rezgh92/CoolitBeat/design/DDD-innovation.md

# DDD-innovation: innovation register, PRISM-15 Rev A

> Lane `innovation`, 2026-10-16. Parent: `docs/cooling/03-architecture.md` (0.1-0.2, 2.1-2.3, 3.1-3.5, 4.1-4.3, 5.1-5.3, 7.2, 9). Inputs: every DDD lane (`DDD-core`, `DDD-grate`, `DDD-plenum`, `DDD-mech`, `DDD-mfg`, `DDD-perf`) and the verification reports under `appendix/verify/`. This is an engineering register for the design report: every benefit is a modelled P50 number (±25 % until E1-E4) with the script it comes from; every novelty statement carries the FTO caveat below. `params-innovation.json` is a stub index of the features.

**FTO caveat (applies to every row).** `appendix/verify/verify-ip.md` is engineering-level patent reading from snippets (about 40 searches, no full claim set read, WebFetch blocked). It is not legal advice. Its findings that bind this register: (a) the kerf is a *weak* design-around of the CoolIT Split-Flow 2008 family ('330/'284/'906/'513, live to about Aug-Sep 2028, '330 PTA bound about Jun 2031); about 49 % of a segment's inflow still enters through fin tips under the 1.2 mm window (`ip_entry_split.py`), and the kerf is worth 2.6 % of the cell dT, so the DOE reading stays open; (b) Microfabrica US 12,255,123 ("hybrid microjet and microchannel array") is medium-high risk unless the jets land on the lip and not on the fins, which Rev A does; (c) Intel 12,133,357 / 11,804,418 and Toyota 11,428,478 are live, close and uncharted; (d) TW I606224 is live to about 2032 for Taiwan manufacture; (e) of the five draft filings only #1 (narrow combination with numeric limits) and #5 (defensive publication of the TTV method) are worth filing; #2 and #4 are anticipated or obvious; #3 is a trade secret. No US offers, sales or evaluation units before the outside-counsel opinion (US$150-250k, weeks 2-8); US launch planned on or after 10 Sep 2028. "Novelty confidence" below is therefore the engineering team's estimate of what survives a search, not an opinion on infringement. Filings and marketing avoid "split", "between the ends" and "halves the path".

Confidence scale: **high** = no close structural match found and the combination carries numeric limits; **medium** = elements known, combination or limits possibly new; **low** = known practice, publish defensively; **none** = standard practice, listed in section 3.

## 1. Innovation register

Column key: problem it solves | mechanism | quantified benefit (script / report) | closest prior art and the difference | novelty confidence (with the FTO caveat above) | test that proves it.

### 1.1 Short, flux-graded flow length (L 7.7 mm on the TTV; 5-12 mm by zone flux)

| Field | Content |
|---|---|
| Problem | A 54 mm split-flow path carries the caloric rise and the fin-top short-circuit along the fins: CoolIT's measured 34.4 / 44.2 K at 15 kW includes a reconstructed base term of 6.6 K and a maximum-minus-average of 9.8 K. Long paths also force coarse gaps for pressure drop |
| Mechanism | 15 lines at 7.7143 mm pitch (7 inlet, 8 outlet, edge outlets with half windows) give 5,040 parallel 7.4 mm fin segments at 0.20 m/s, Re 44. Fin dP is 1.07 kPa, so the gap (0.15 mm) is set by fouling and h_eff (117 kW/m2K), not by dP. Flow length is graded by zone flux: ≥ 250 W/cm2 5-6 mm, 100-250 W/cm2 6-8 mm, 50-100 W/cm2 8-12 mm, < 50 W/cm2 12 mm (architecture 3.3, corrected: L 4 mm is never best; the ripple crest is flat within 0.35 K over L 5-8 mm) |
| Quantified benefit | Benchmark 31.1 / 38.8 K paste, 29.2 / 34.9 K PCM at base 0.85 (`perf_datasheet.out` §1; architecture 31.0 / 38.7 and 29.0 / 34.8 at 0.80, `final_thermal.out` §1). Term budget vs the CoolIT calibration: convection 10.9 vs 12.6 K, base 2.6 vs 6.6 K, 2-D penalty +0.9 vs +1.4 K (end-face exit, `vp_run2.py`); maximum-minus-average 7.8 vs 9.8 K. Capacity at Tcase ≤ 85 C: 15.7 / 18.4 kW vs ~12.9 / 14.8 kW (+22-24 %). Low-flow concession: the average is lost by 17 % at 0.25 LPM/kW (isothermal-cell caloric penalty, `perf_datasheet.out` §4) |
| Closest prior art | Harpole and Eninger (SEMI-THERM 1991, NPL) and Ciaccio US 5,088,005 (fee-expired): the manifold-microchannel concept itself. Cooligy US 7,104,312 (expired, zoned flow lengths), Toyota US 11,149,937 (graded MMC, fee-expired), HUST 12,178,022 (zigzag diverter, power module). Purdue HMMC (Garimella/Weibel) and IBM Zurich (Brunschwiler) hierarchical manifolds at 0.5-2 mm pitch, mostly two-phase or embedded. **Difference:** a 7.7 mm pitch chosen as the 2-D optimum for a *skived* 0.15/0.15 x 2.0 field on a conventional vacuum-brazed stack, with the pitch rule published as a flux table rather than a micro-fabricated array. CoolIT Split-Flow is the same idea at one slot per plate |
| Novelty confidence | **Low** as a concept (the architecture calls it a "proven subset"). The flux-graded rule is anticipated or obvious and a selection rule risks 35 USC 101 (verify-ip filing #2): publish defensively. The pitch is inside the Split-Flow DOE argument until Sep 2028 (caveat (a)) |
| Proving test | E3 OCP thermal at 6 flows on TTV-A and TTV-100, 5 plates x 3 mounts, PCM and paste, post-test BLT (architecture 1.3); the maximum must be lower than 44.2 K at every flow and the average lower from 0.75 LPM/kW up. E2 single-cell CFD confirms the 2-D model within ±25 % |

### 1.2 Kerfed skived fins with full-height entry

| Field | Content |
|---|---|
| Problem | Fluid entering a fin field from above through a window runs along the fin tips (Hele-Shaw short-circuit) and leaves the fin roots, where the heat is, under-fed; the fins are unmixed across their height at Re 35-200 |
| Mechanism | 13 interior kerfs 0.30 +0.05/-0 wide, sawn 1.925 ± 0.025 deep from the planed tip plane so the floor sits 0.05-0.10 above the fin root (never into the base; hinge ≥ 0.80), full depth over \|y\| ≤ 48.1 with an arc ramp to zero at 54.0 so the saw never touches the rim; 2 edge channels 0.35 wide (DDD-core 5). Kerf permeability w²/12 is ~8x the fin-gap value, so the kerf acts as a distribution duct feeding the segment end face over the full 2.0 mm height; kerf top ≤ 1.3 m/s, fin-gap 0.198 m/s. 15 micro-grain carbide slitting saws Ø20 x 0.28 on one arbor, wax-potted fins, tooth force 1.3-2.1 N vs 1.4-5 N fin lateral capacity, 10,080 cut sites deburred to ≤ 15 µm |
| Quantified benefit | Kerf worth 0.4 K on Rev A and 0.66 K on the draft core (architecture 3.2; `vp_cell.py` / `vp_run1.py` confirm 0.66 K at L 6: no-kerf 23.54 K); +0.30 K if the inlet kerf fills by impaction, +0.66 K if both fill (`verify-physics.md` §2c); kerf permeability ratio 4-16 moves the result ±0.25 K. Arc ramp costs +0.014 K average (`core_geom.out` §3). Cost US$2.8 at 100k (`mfg_cost.out` §3); dropping the kerfs saves US$3.4 and costs +0.4-0.7 K (`verify-close-the-losses.md`) |
| Closest prior art | Cross-cut skived fins (established practice, verify-ip #1 row); Toyota US 11,428,478 (gridded fins in an MMC sink, live to ~2040); Intel 11,804,418; Cooligy US 6,986,382 interdigitated fingers; LLNL Bonde US 5,099,311 and Walpole US 5,099,910 (expired). **Difference:** the kerf is a sub-0.3 mm saw cut that stops 0.05-0.10 above the base in a tied field, sized so its top-entry velocity stays ≤ 1.3 m/s and its area (1.33x the orifice area) does not meter; the slit is a *distribution duct*, not the fin entry. CoolIT '330 claims an inlet opening "between the ends" of a continuous channel; verify-ip finds the kerf does not end the flow path |
| Novelty confidence | **Low-medium.** Novel only as the narrow combination of filing #1 (kerf/window ratio, floor stub, orifice-to-braze clearance ≥ 0.35 mm, meter/header head ratio ≥ 6); detectable by teardown, easy to design around. The admissions risk is real: never describe the kerf as part of the inlet opening. The stronger structural fix (window narrowed to the kerf, -0.11 K, `cell2d.py`) is carried as the pre-freeze option; the no-kerf R1 fallback is non-US only (caveat (a)) |
| Proving test | E1 skive and gang-saw trial: pitch and thickness Cpk ≥ 1.33, burr ≤ 15 µm by profilometer on 3 kerfs x 5 fins per lot, root metallography, ISO 16232 flush with no particle > 50 µm. E2 single-cell CFD + water-table PIV: kerf share of segment inflow, fin-top velocity ≤ 0.5 m/s at 18 LPM. Fin-field dP taps on the first five plates: 1.07 ± 0.2 kPa viscous term (> 1.3 = filler in kerfs or windows) |

### 1.3 Off-braze-plane graded orifice meter in the grate web, jets landing on the grate lip

| Field | Content |
|---|---|
| Problem | (i) A centre-fed plenum has a momentum-driven pressure profile along y, so an ungraded meter mis-feeds the line ends by ~12 %; (ii) orifices at a braze plane draw filler and lose area; (iii) jets aimed at the fins break the 0.5 m/s fin-entry cap, erode the pressure boundary and read on the Microfabrica "microjet onto the heat-exchange region" claim |
| Mechanism | Two OFE laminations brazed in the one cycle: land plate GRT-L 1.30 (windows 1.2 x 108, recess pockets 2.70 wide x 0.80 deep from the top face, capillary-break grooves 0.15 x 0.08) and meter web GRT-W 0.40 at z 4.10-4.50 with 378 inlet orifices 0.50 x 0.99-1.12 (r 0.10) in 5 size steps spanning 1.134x in area, centred at x_line ± 1.00, alternating sides so each 0.75 lip receives 27 jets per line. Stand-off H 0.80 = 1.6 orifice widths (inside the potential core), jet footprint 0.670-1.330 on the 0.60-1.35 lip, inner margin 0.070 nominal / 0.023 RSS. Orifices ≥ 0.40 from the nearest filler (rule ≥ 0.35); the 0.3 mm mask is a starve zone and the grooves stop the capillary front. Because the plenum profile and the orifice loss both scale with u², one artwork balances every flow |
| Quantified benefit | Per-orifice max/min ±2.2 % at 9, 18, 27 and 36 LPM vs 1.118-1.122 ungraded (`grate_artwork.out`; target ±3 %); robust to Cd 0.65-0.80 (1.044-1.055), a ±2 mm window move and a two-arch feed (1.058). Meter 2.31 kPa at 1.54 m/s mean, 1.64 m/s max orifice, 2.0 m/s cap reached at 23.4 LPM (`grate_cell.out`, `perf_datasheet.out` §8). Fin-top estimate 0.40 m/s at 18 LPM vs the 0.5 cap (DDD-grate 5). Thermal cost of landing on the lip instead of the kerf floor ≈ 0 K (floor h 6 vs 12 kW/m2K changes nothing in `cell2d.py`). Enabled the 5.0 mm plenum: height 26.4 → 20.8 mm (`ctl/plenum_height.py`, `plenum_graded.py`). Per-SKU change is the web only, ~US$2-4 laser-pierced |
| Closest prior art | Cooligy US 6,986,382 / 7,156,159 (interdigitated manifold over microchannels, expired); Mikros normal-flow (NCP) laminated plates where jets through thin sheets strike the heated base; JetCool / MIT US 11,018,077 and 11,594,470 (microjets onto the package with local returns); Microfabrica US 12,255,123 (hybrid microjet + microchannel, to ~2042, parent 9,953,899 to ~2036); IBM Zurich hierarchical manifold with direct jet impingement; orifice-compensated headers in plate HX practice. **Difference:** the jets never touch the heat-exchange surface: they stagnate on a dedicated lip of the grate 1.3 mm above the fin tips and the fluid then descends a 1.2 mm window at ≤ 0.4 m/s; the meter sits 0.35-0.40 mm clear of any braze plane; the grading is a 5-step quantised area ladder solved on a 432-cell 1-D manifold model and re-issued per package |
| Novelty confidence | **Medium**, the strongest element of filing #1 (stepped recess + lip landing + clearance limits). Microfabrica risk moves from medium-high to medium-low only because of the lip landing; the 0.4 mm-offset fallback that put jets on fin tips is deleted (caveat (b)). Mikros/Jabil and IBM Zurich families not yet charted |
| Proving test | E2 single-cell CFD + water-table PIV: footprint wholly on the lip, fin-top ≤ 0.5 m/s, fixes H 0.70-0.90 and lip 0.70-0.80 (O1). Coupon Cd(Re) in both directions, Re 300-1700, 5 sizes; if Cd ≠ 0.72 every area scales by 0.72/Cd. 100 % backlit vision of orifice area before and after braze (±1 %); E1 sections show no filler within 0.15 of a window edge. Three-flow dP at Cpk ≥ 1.33 screens a mis-sized artwork (±2 % area = ±1.2 % plate dP). E4 lip erosion at 1x/1.5x/2x for 1,000 h |

### 1.4 Tied sandwich with a 0.85 mm pressure-neutral base

| Field | Content |
|---|---|
| Problem | In a conventional plate the base is a pressure vessel wall: at MAWP 1.03 MPa the 117 cm2 field carries 12 kN, so the base is 2-3 mm thick (CoolIT reconstruction base term 6.6 K) and bows under pressure and clamp, which opens PCM and LM bond lines |
| Mechanism | Fin tips (planed coplanar with the rim top within 0.02) are brazed to the grate lands with 12-15 µm BAg-8 preform ladders; the grate carries the plenum legs, the separator and the cap feet, so the pressure load on the base is self-equilibrated by 360 fins x 14 segments of ties and never enters the clamp budget (DDD-mech 5). The base can then be fly-cut after braze to 0.85 (+0.05/-0.05; 0.80-0.90 accepted; 1.0 fallback) at ≤ 20 µm flatness, Ra ≤ 0.8. The governing defect is one unbonded land strip spanning kerf to kerf; the 0.85 base is gated on E1 showing per-strip detection by the confocal proof scan (bulge ~1.8 µm at 1.55 MPa) |
| Quantified benefit | Base term 2.79 K at 0.85 vs 6.6 K in the CoolIT calibration budget and 3.29 K at the 1.0 fallback (+0.55 K average, +0.36 K max; `perf_datasheet.out` §1). Tie stress 8.9-11.6 MPa mean, 22-28 MPa local vs 40 MPa allowable at 3.1 MPa design burst; plenum wall 29.8, separator 22.8 MPa (`ctl/pkgA_dp_stress.out`, DDD-grate 8). Clamp bow 22.6 µm concave at 2 kN TTV vs thermal +18.7 µm convex at 15 kW → net -4.0 µm (`mech_calc.out` §7). Fly-cut on the tied field: foundation modulus ~29 kN/mm3, 0.3 µm under 50 N thrust, no chatter (verify-mfg #13). Unverified upside: a flat tied face reduces the mean paste BLT, -0.2 to -0.5 K per µm (`verify-close-the-losses.md` 2.5) |
| Closest prior art | Brazed plate-fin heat exchangers (fins bonded to both parting sheets, standard since the 1940s); vacuum-brazed cold plates with a lid brazed onto skived or folded fin tips (common); CoolIT compliant-member and IBM TCM clamping for flatness. **Difference:** the tie is used deliberately to take the pressure boundary out of the heat path (base thinner than any fin-root hinge rule would allow for a vessel wall) and is controlled per land strip, with the defect case (one strip, collapse 1.8-2.6 MPa, leak-tight at MAWP) analysed and screened |
| Novelty confidence | **Low** for the tie itself; **medium** for the thin-base rating logic and the per-strip screen, which is a trade secret (filing #3: unenforceable offshore and patenting would disclose it). Both are at parity with the proven-subset positioning |
| Proving test | E1 tie-braze matrix: every land strip ≥ 70 % bonded over any 10 mm (CT), unbonded-strip bulge detected at base 0.85 by confocal at 1.55 MPa, burst ≥ 4.5 MPa, no plastic set after lot over-proof 2.5-3.1 MPa, flatness ≤ 20 µm after fly-cut. E3 heated pressurised flatness scan (O-M2) separates the 22.6 and 18.7 µm terms |

### 1.5 Folded single-sheet plenum and drawn skirted cap: one external perimeter seam

| Field | Content |
|---|---|
| Problem | The draft's six stamped laminations had six external perimeter seams (incumbent: one) and were unbuildable as drawn (web/t too small; verify-mfg #5); each external seam is a leak path and a yield loss |
| Mechanism | PLN-C: one 0.80 OFE strip pierced flat (14 windows 5 x 10 at y -21/-7, 8 outlet slots, 14 bleed holes Ø0.60-1.10, 32 end tabs) then folded on a sequential corrugating machine into 16 walls / 15 channels 6.914 x 5.00 at 7.7143 pitch, closed by two comb end frames; the grate web is the floor of every inlet channel. CAP: 1.00 OFE drawn in 3 stations (skirt box, arches 12 x 8 + cross domes, Ø26 port pockets), skirt down to the core land at z 1.50 over the 121.4 rim lap; 20 mm bosses brazed in the pockets with BAg-8 rings. Every plenum, separator and grate joint lies inside the skirt, so a missed joint bypasses (25 µm gap: 0.009 LPM, invisible and harmless) and cannot leak |
| Quantified benefit | External seams 6 → 1 lap + 2 bosses (+2 tap stubs on -T SKUs) (architecture 5.1; `bom.csv`). Plenum US$4.4 and 0.165 kg vs the draft's US$7.5 / 0.19 kg; cap US$6.3 incl. bosses (`mfg_cost.out` §3; architecture 5.4 header/cap 14.5 → 5.3). Plenum wall 29.8 MPa, arch hoop 18.6, pocket 24.8 MPa at 3.1 MPa vs 40 allowable. Height 20.8 mm at the bar vs 26.4 draft and 22-28 estimated for the incumbent. Fixture pressure on the folded stack ≤ 0.10 MPa (0.08 design, TZM leaf springs, `mfg_cost.out` §1). Leak target ≤ 50 ppm leakers at shipment, ~1 FIT |
| Closest prior art | Folded heat-exchanger fins and transformer corrugations (US 5,694,803, US 6,195,874); deep-drawn cups and cold-plate covers (standard); CoolIT Split-Flow housings. **Difference:** the corrugation *is* the plenum (channel floor = the metering web), the comb frames make it self-fixturing, and the drawn skirt makes every inner edge internal in a single braze |
| Novelty confidence | **Low** (assembly method; publish defensively with the OCP disclosure). No IP exposure found |
| Proving test | E1 3-channel fold coupons (bend radius, K 0.31-0.39, springback), then Build A (wire-EDM fallback); He leak ≤ 1e-6 mbar·L/s dry, 100 % proof 1.55 MPa, lot burst ≥ 4.5 MPa after thermal cycling; IR flow screen for bypass (blocked line resolution 5-10 mm) |

### 1.6 Doubled outlet header + 0.5 kPa outlet orifice row for segment balance

| Field | Content |
|---|---|
| Problem | The meter fixes each line's flow but not the left/right split of a kerf's flow into its two neighbouring segments; only the 1.07 kPa viscous fin resistance opposes outlet-side pressure differences, so segment max/min reached 1.23-1.43 in the draft (1.41-1.71 at 36 LPM) |
| Mechanism | Four outlet arches (322 mm2 per half, 0.47 m/s) against two inlet arches (161 mm2), so the outlet header runs at half the inlet velocity head; plus a row of 54 (edge 27) Ø1.00 holes in the outlet window web adding 0.50 kPa at each line's nominal flow, lumped per line (`grate_outlet_row.py`) |
| Quantified benefit | Segment max/min at 18 LPM: 1.287 with a single outlet header → 1.092 with both fixes (1.100 header doubled, no row); at 36 LPM 1.546 → 1.148 (`grate_outlet_row.out`). Weakest segment +0.41 K core at 18 LPM against the 1.5 K flow hot-spot allowance (margin 1.09 K, `perf_datasheet.out` §2). Cost 0.50 kPa and no height; outlet header 1.55x margin against the 0.9 m/s CDA band for > 60 C return |
| Closest prior art | Outlet-side restriction and header area ratios for branch balance are textbook manifold design (Bajura and Jones 1976; Majumdar 1980); Cooligy and CoolIT headers. **Difference:** none of substance; the specific 2:1 header ratio and 0.5 kPa row are design values |
| Novelty confidence | **None.** Listed in section 3; not claimed |
| Proving test | E2 water table: segment-level max/min by dye and IR ≤ 1.15 at 18 LPM, ≤ 1.20 at 27 LPM (combined along-plenum and segment); E3 maximum-minus-average 7.7 K paste / 5.7 K PCM predicted |

### 1.7 Fin-field dP taps as the fouling and build signature

| Field | Content |
|---|---|
| Problem | Port-to-port dP is 81 % inertial (meter, ports, headers): a 10 µm deposit on each fin wall raises fin dP 54 % but plate dP only 6-8 %, so no port measurement can see fouling or a bad tie braze (`verify-hydraulics.md` §4) |
| Mechanism | Two Ø1.00 gun-drilled or EDM taps along y at z 1.40 from -y bosses at x 0.000 (inlet line k = 7) and x +15.429 (outlet line k = 9), 15.35 long, with Ø1.65 x 4.0 counterbores for Cu 1.6 x 0.3 stubs brazed in the same cycle (DDD-core 3.10; -T SKUs). They read the fin-field pressure difference (inlet kerf to outlet kerf): the 1.07 kPa viscous term, linear in flow and viscosity |
| Quantified benefit | Fouling sensitivity x7-9 over port taps; thresholds +10 % warning (≈ 2 µm per wall), +25 % service (≈ 5 µm) (architecture 7.2). Production use: > 1.3 kPa = filler in kerfs or windows, < 0.9 kPa = missed tip joints (bypass) (`perf_datasheet.md` §9 item 4). Converts the unmeasurable 10-year life into a dose qualification: 100x particle dose for 1,000 h (~11 years) with ≤ 10 % fin-field dP drift and ≤ 1 K (E4). Cost in the TAP/GUARD line US$8.3 total |
| Closest prior art | Heat-exchanger fouling monitoring by dP (universal); filter dP alarms; CoolIT US 9,052,252 (in-plate leak sensing); NVIDIA "intelligent plate" filings (uncharted). **Difference:** the taps straddle only the viscous element inside a manifold plate, which is possible because the inlet and outlet plenums are physically separate layers above the field; sensor records published as PLDM/Redfish, plate stays passive |
| Novelty confidence | **Low-medium.** Possibly new as a cold-plate feature; of little value as a patent (infringed by the operator, detectable only in a fleet). Publish with the OCP method; chart CoolIT '252 and the NVIDIA filings before any tray-module design |
| Proving test | First five plates: fin-field dP at 6 flows against the 1.07 kPa model; E4 dose test with the taps as the primary metric; correlation of tap reading with CT-confirmed tie defects on E1 coupons |

### 1.8 Per-package artwork zoning

| Field | Content |
|---|---|
| Problem | Lidded packages (4 dies at 350 W/cm2 + 16 HBM at 40 W/cm2 on 110 x 120 mm) need 85-90 % of the flow under the die block and 0.3-0.5x average per area under HBM; a new zoning in a machined or die-stamped manifold costs a US$0.4-1.0 M die set and months |
| Mechanism | Only GRT-W (0.40 strip, laser-pierced, 100 % backlit vision) changes per package; land plate, plenum fold and cap are per pitch family. Zoning by heat: die zones at line pitch 5.5 (L 5.5), HBM and margin at 11; every zone fed in parallel so HBM is never downstream of a die; unheated margin gets only plenum-end bleeds (Ø1.10 for 4 % of line flow; the draft's Ø0.60 gave 1.2 %). The HBM pedestal step S (0-0.40, ±0.05) is cut in the same post-braze fly-cut |
| Quantified benefit | PRISM-G example: 17 lines, 840 holes, 190.1 mm2 inlet area, die-zone orifices 2.30 kPa at 1.54 m/s, HBM 2.90 kPa (`grate_artwork.out` §PRISM-G; `artwork_prism_g_example.csv/.dxf`). Hottest die cell with LM: ~94-98 C case vs ~121 C for a split-flow reconstruction, model vs model (`prism_scorecard.out` §6); P-grade ~84-88 C. Tooling cost per zoning ~US$2-4 per plate and weeks, not a die set. Caveat found: HBM orifices reach 2.21 m/s at 150 % rated, so a product artwork uses L 8 in the HBM zone or the -HF die meter |
| Closest prior art | Cooligy US 7,104,312 (zoned manifolds, expired); Corintis topology-optimised cold plates; Toyota US 11,149,937; the project's own PSM-12 slit-pitch zoning. **Difference:** the zoning lives in a flat 0.4 mm perforated sheet solved by a 1-D manifold tool, so it is a data file, not a part |
| Novelty confidence | **Low** (anticipated / obvious; 101 risk on the rule). The zoning tool and its calibration are the moat (architecture 9: trade secret); the artwork method goes into the defensive publication (#5), after clearing NVIDIA US 12,446,195 for the TTV itself |
| Proving test | E3 on the real-package TTV-D (die + HBM heaters) with the -G artwork: die and HBM case temperatures against the zoned model; segment balance by IR at 2 kW |

### 1.9 Interface tiers set by face finish

| Field | Content |
|---|---|
| Problem | One brazed plate must serve drop-in PCM users, OEM liquid-metal co-design and bare-die chip co-design without a new core |
| Mechanism | The tier is chosen after braze, in the fly-cut and finishing cell: T1 lapped bare Cu for PCM (0.055 cm2K/W at 25 psi; 0.07 at 4-12 psi package retention); T2 3-5 µm electrolytic Ni on the face only for Ga-In LM, 20-30 µm bond line, non-fluorinated dam, no Al in the LM zone; T3 crowned stepped pedestal ±0.05 with Ni or W barrier for bare die; T3B micro-channel-lid insert on the roadmap |
| Quantified benefit | TIM term 9.0 K paste → 7.1 K PCM → 1.9 K LM: 31.1 / 38.8 → 29.2 / 34.9 → 24.1 / 28.9 K (`perf_datasheet.out` §1); capacity 15.7 → 18.4 → 25.4 kW thermal (19.5 velocity-rated); inlet allowed 46.2 → 50.1 → 52.3 C. Form rule 0-10 µm concave at 20 C (IR-M5) because corners lift 13-19 µm hot |
| Closest prior art | Ni-plated faces for liquid metal (Indium Corp. and Coollaboratory application notes), stepped pedestals for HBM (every GPU plate), lapped Cu for PCM. **Difference:** none |
| Novelty confidence | **None.** Section 3; not claimed. CoolIT compliant-member patents ('886/'733, ~2040) are low risk for the T3 spring-screw gimbal but must be charted |
| Proving test | E3 PCM and paste on TTV-A; E5 LM on the Ni-plated twin fixture (17-4PH, no Al), 1,000 h at 85 C with BLT and intermetallic sections |

### 1.10 Filtration ladder

| Field | Content |
|---|---|
| Problem | A 0.15 mm gap behind a 50 µm absolute filter has ~7 years of exclusion life (a 0.2 mm gap ~15); the drop-in plate cannot win fouling life at equal filtration and must not sieve anywhere upstream of the fins |
| Mechanism | Passage hierarchy port 20 > header 8 > plenum 5 > window 1.2 > orifice 0.5 > kerf 0.3 > gap 0.15 mm, every stage ≥ 3x the last filter's absolute rating. Ladder: supplied tray cartridge ≥ 150 cm2 pleated 33 µm absolute 316L with dP taps and dry-break valves → plate guard 50 µm absolute square-weave 316L as an inside-out radial diffuser in the inlet boss (≥ 25 cm2, 0.12 m/s face) → fins. The plate is symmetric and back-flushable at 1.2x rated through a 25 µm bag (Cd qualified in reverse) |
| Quantified benefit | Exclusion life ~12 years behind the 33 µm cartridge vs ~7 at 50 µm (relative Wyss-based model, `appendix/physics/fouling-filtration.md`); cartridge life to 50 % blockage ~160 / 16 / 1.6 days at the three assumed loop concentrations, guard alone 65 / 6 / 0.6 days (architecture 7.2). Guard dP 0.1-0.2 kPa clean (0.30 booked); diffusing the port jet also holds line max/min at 1.03 instead of 1.06 (`final_segbal.out`). R+ grade behind the cartridge: 32.2 / 40.3 K on the 100 cm2 hard mode (win P 0.69 / 0.79) |
| Closest prior art | Filtration-to-gap rules of thumb, OCP and vendor loop guidance, strainer-in-port designs. **Difference:** none beyond stating the numbers |
| Novelty confidence | **None** (filing #4 obvious; a system claim would be infringed by customers). Publish in the OCP contribution |
| Proving test | E4: ISO 12103 + CuO + EPDM dose at 100x for 1,000 h with the fin-field taps; cartridge and guard dP curves; back-flush recovery; the "10-year dose qualified" claim replaces any life claim |

## 2. Design story (one page, plain engineering)

The incumbent plate solves a 15 kW problem the way every cold plate has for twenty years: a thick copper base as the pressure vessel wall, fins on top, and a lid. Coolant comes in one end of the fin field and runs tens of millimetres along the fins. That long path does three bad things at once. The coolant warms as it goes, so the far end runs hotter; the pressure drop of a long thin channel forces the designer to coarsen the gaps, which cuts the heat-transfer coefficient; and because the fluid enters from above and the fins are unmixed across their height, a good share of it runs along the fin tips and never reaches the roots where the heat is. The base, being a vessel wall, is 2-3 mm thick and adds several kelvin of its own.

PRISM takes those four problems apart one at a time with ordinary processes. First, it cuts the path to 7.7 mm by feeding and draining the fin field from above at fifteen lines: 5,040 short segments in parallel instead of a few hundred long ones. The fin dP falls to about 1 kPa, so the gap can be the 0.15 mm that heat transfer and filtration want rather than what pressure drop allows. Second, under every feed and drain line a 0.3 mm saw kerf lets the coolant enter the segment over the full 2 mm fin height, which closes the tip short-circuit and is worth about half a kelvin. Third, the fins are brazed at their tips to a grate above them, so the fin field itself carries the pressure load as thousands of small ties. The base stops being a vessel wall and is fly-cut after braze to 0.85 mm, flat to 20 µm; it no longer bows under pressure or clamp, which is what lets PCM and liquid metal hold their datasheet resistance. Fourth, the grate is also the meter: graded orifices in a thin web above a stepped recess set each line's flow so that it is uniform along the plenum at every flow rate, because the plenum's pressure profile and the orifice loss both scale with velocity squared. The jets strike a lip of the grate, not the fins, and the fluid then descends a wide window at low speed.

Everything above the grate is sheet metal: a plenum folded from one strip, a separator, and a cap drawn with its own skirt that laps onto the base land, so the plate has one external seam plus two port bosses and every internal joint can only bypass, never leak. The whole stack is brazed in one vacuum cycle at 0.08 MPa fixture pressure. The predicted result at the published 15 kW, 18 LPM point is 31.1 / 38.8 K on paste against the measured 34.4 / 44.2 K, 29.2 / 34.9 K on a PCM pad, at 7.6 kPa plate pressure drop, 20.8 mm at the bar and 1.24-1.28 kg, for about US$165 at 100k per year. The honest concessions are that it costs about 31 % more per plate (parity per kW), has a shorter fouling exclusion life at equal filtration and therefore ships with a 33 µm tray cartridge, loses the average at very low flow, and has no field record. None of the parts is new. What is new is the way four known ideas are made to hold each other up in one brazed stack built from catalogue processes, with the numbers that make them fit.

## 3. Not novel, not claimed

| Item | Why it is standard practice |
|---|---|
| Skived OFE copper fins 0.15/0.15 x 2.0 mm | inside the published CTX-class skiving envelope (fin ≥ 0.08, centre distance ≥ 0.16 mm) |
| Manifold-microchannel topology (feed from above, short along-fin path) | Harpole/Eninger 1991, Ciaccio US 5,088,005, Cooligy, Purdue HMMC, IBM Zurich |
| Brazing fin tips to the layer above (the tie) | plate-fin HX practice; vacuum-brazed lidded cold plates |
| Outlet-side restriction and 2:1 header area for branch balance (1.6) | manifold textbooks (Bajura and Jones) |
| Orifice-compensated headers | plate HX and fuel-rail practice; the u² argument is elementary |
| Folded corrugations, comb end frames, deep-drawn caps, brazed port bosses | HX forming (US 5,694,803, US 6,195,874) and sheet-metal practice |
| Single-cycle vacuum brazing with BAg-8 preforms, Ag plating or Cu-Sn TLP | standard joining routes; C2 is a cost route, not an invention |
| Post-braze fly-cut face, lapped Cu, Ni plate for LM, HBM pedestal step (1.9) | every lidded-GPU plate and LM application note |
| 50 µm guard screen, 33 µm tray cartridge, gap ≥ 3x filter rating (1.10) | filtration rules of thumb; OCP guidance |
| dP-based fouling monitoring and filter alarms (1.7, generic part) | HX operations practice |
| Captive spring screws, load frame, backplate, shoulder-screw pass-throughs | retention hardware practice |
| Flux-graded flow-length table (1.1) and heat-based zoning (1.8) | Cooligy '312, Toyota '937, HUST '022; a selection rule |
| He leak, proof, lot burst, IR flow screen, 3-point dP at Cpk ≥ 1.33 | production test practice; the per-strip confocal method is a trade secret, not a claim |

## 4. Stretch innovations (not in Rev A)

**S1. Staggered (chevron) line pattern to halve the kerf-to-kerf ripple.** The maximum carries half the computed case ripple, 5.39 K pk-pk at base 0.85, because every fin gap sees the same inlet-outlet sequence along x and the base can only smooth it over the 3.7 mm half-pitch by lateral conduction. If adjacent lines were offset by half a segment along y (a chevron or stepped kerf and matching chevron plenum channels), the hot end of one cell would face the cold end of its neighbour 0.3 mm away across a fin, and the conduction length that smooths the ripple would fall from the 3.7 mm half-pitch to about half the stagger period. Conduction smoothing scales roughly with length squared, so a 4 mm stagger period could cut the ripple by a factor of two or more, worth about -1.3 K on the maximum and nothing on the average. Caveat: gang saws cut straight lines, so the kerfs would need wire-EDM or laser (the kerf is 2.8 US$ today, perhaps 8-15 as EDM), the plenum fold tool becomes a chevron tool, the along-plenum artwork solver becomes 2-D, and a transverse slot pattern over parallel channels reads closer to the Cooligy and Split-Flow art, so it would need its own chart.

**S2. Viscosity-driven self-balancing of hot segments.** Fin dP is viscous (∝ µ u) and the PG25 film viscosity falls about 30 % between 35 and 50 C (1.60 → 1.12 mPa·s). At fixed segment pressure, a segment under a hotter zone would therefore draw more flow in proportion to its own temperature rise, a passive negative feedback that an inertial meter deliberately suppresses (the meter was chosen so the balance is flow-independent). If a zoned SKU moved part of the 2.3 kPa inertial meter budget into a viscous element (a longer or thinner outlet path, or a laminar-flow row of 0.2 mm slots at Re < 100), a 10 K hotter segment would self-feed by 10-15 % with no moving parts. Caveat: the plenum profile sensitivity that the u² meter cancels comes back in proportion to the viscous share; the gain is confined to zones with ≥ 10 K local coolant rise; the 0.2 mm viscous element breaks the "gap ≥ 3x filter" ladder unless it sits downstream of the fins; and water loops (µ 0.55 mPa·s, weaker temperature slope) get less than half the effect. Worth a `cell2d`/`plenum_graded` study, not a build.

**S3. 0.60 mm base with 100 % per-strip tie verification by lock-in thermography.** The base term is 3.29 K per mm (2.79 K at 0.85), so a 0.60 base would save about 0.8 K on every TIM and 0.5 K on the maximum, and it is still 4x the 0.15 fin thickness for the fly-cut. The pressure-neutral tie makes it structurally possible: wall and tie stresses do not change with base thickness. What changes is the governing defect: one unbonded land strip collapses at 1.8-2.6 MPa at 0.85 and, scaling with t², at about 0.9-1.3 MPa at 0.60, which is at or below MAWP 1.03 MPa, so it stops being a rating problem and becomes a safety problem that the confocal proof scan alone (resolution 1 µm, bulge ~1.8 µm at 0.85) cannot be trusted to catch at 100 %. The enabling step is a second independent screen: lock-in or pulsed thermography on the as-brazed face before fly-cut, where an unbonded strip 7.4 x 1.8 mm shows as a phase lag of the order of the fin-tip joint's contact resistance over a 0.6-0.85 mm copper skin (thermal diffusion time L²/α ≈ 9 ms for 1 mm Cu at α 1.1e-4 m2/s, so a 5-30 Hz lock-in band). Caveat: the method is unproven on a 50 %-solid fin foundation that itself conducts heat sideways; it would need an E1 sub-study with deliberately unbonded strips, and the filing route is trade secret (filing #3 logic), so it protects only our own plates.

## 5. Files

| File | Content |
|---|---|
| `DDD-innovation.md` | this register |
| `params-innovation.json` | stub: feature ids, novelty confidence, filing or publication route, proving test, source scripts |
| Sources | `appendix/verify/verify-ip.md`, `verify-physics.md`, `verify-hydraulics.md`, `verify-manufacturing.md`, `verify-close-the-losses.md`; `appendix/verify/final/final_thermal.out`, `final_segbal.out`; `appendix/verify/ctl/plenum_graded.py`, `plenum_height.py`, `pkgA_dp_stress.out`; `appendix/verify/ip_entry_split.py`, `vp_cell.py`, `vp_run1-3.py`; `design/grate_artwork.out`, `grate_cell.out`, `grate_outlet_row.out`, `perf_datasheet.out`, `mech_calc.out`, `mfg_cost.out`, `core_geom.out`, `bom.csv` |
