rezgh92/CoolitBeat/appendix/design/proposal-jet-hybrid.md

# JetFin Hybrid (JH): a nozzle-metered slot-jet-into-micro-fin cold plate (key: jet-hybrid)

Architecture proposal, 2026-10-13. Benchmark: CoolIT 15 kW Split-Flow coldplate (June 2026): 15 kW, 18 LPM PG25, 45 C inlet, 34.4 K average / 44.2 K maximum case-to-inlet, paste TIM, pressure drop undisclosed (our reconstruction ~22-25 kPa, band 17-42 kPa). All performance numbers come from `design/jet/jet_hybrid_model.py` (full output in `design/jet/jet_hybrid_model.out`). That script imports the programme's `coldplate_model.py` unchanged for the CoolIT and HMMC reference rows and uses the same series network (isothermal-cell caloric term, TIM, base, convection, hot spot = flow term + TIM scatter) on the calibrated 117 cm2 footprint. Scoping accuracy is +/-25-30 % per term. It is not CFD.

## 1. Concept in one page

**What it is.** JH is a copper plate with a three-level manifold, diffusion-bonded in one furnace cycle. The last manifold level is a two-layer **nozzle-tie laminate** bonded directly onto the tips of a skived fin field (0.15 mm gaps, 0.10 mm fins, 2.0 mm tall, 1.0 mm base). The laminate carries 0.22 mm slot nozzles at 8 mm pitch, interleaved with 1.0 mm return slots. Each slot nozzle crosses all 432 fin gaps. In each gap it issues a planar jet at 1.55 m/s (18 LPM) that hits the base between the fins, turns, runs 3.4 mm along the channel and rises into the next return slot. The nozzle does three jobs at once:

1. **Metering.** The nozzle carries 1.76 kPa of the 1.97 kPa branch, which is 6.4x the header dynamic head. It is inertial, so flow uniformity does not depend on flow rate.
2. **Zoning.** The nozzle open-area map is the power map, set by photo-tool artwork.
3. **Heat transfer.** The plate pays the metering loss anyway. JH spends it at the fin roots, where the jet raises h, instead of in a comb that sits 8 mm upstream.

Over the dies of a real package the nozzle pitch closes to 6 mm (4 mm as a stretch option), and 91 % of the flow goes there. Over HBM and unheated margins the laminate carries open, upstream-metered slots with no jets. So the plate puts jets over the dies and metered channels over the HBM.

**The answer the lens was asked for.** Do jets beat the hierarchical manifold micro-channel (HMMC) at equal pumping power and equal fouling constraints?

- **As an area-filling core, no.** Continuity fixes the problem. At 18 LPM over 117 cm2 the volumetric flux is only 2.56 cm/s, so a fouling-tolerant 0.3-0.5 mm nozzle array reaching 1-5 m/s must be sparse (2-6 mm pitch). Martin, Womac and a laminar stagnation model then give area-averaged h of only 9-32 kW/m2K at 4-40 kPa (section 2.1). That is 4-14x below the HMMC-R's 127 kW/m2K finned h_eff at 5-6 kPa. The literature's 100-300 kW/m2K microjets use 31-150 um nozzles at 10-40x our flux density.
- **As a hybrid on the same 0.15 mm fins, marginally on a uniform 15 kW TTV.** h_eff rises from 127 to 147 kW/m2K (+15 %) at the same plate dP (5.5 vs 5.7-6.0 kPa). That is worth -1.1 K average / -1.2 K maximum, or -1.3 K at equal pumping power. This is inside the model's uncertainty band.
- **Over hot spots, yes.** At 350 W/cm2 reticle dies with heat-proportional zoning, the die-zone h_eff is 158 kW/m2K (6 mm pitch) to 172 kW/m2K (4 mm pitch), against 127-133 for the open-slot manifold. That is -3 to -7 K at the hottest die. It reaches the HMMC performance core's (HMMC-P) result without its 33 um loop filtration.
- **On coarse, fouling-proof channels, decisively.** Jets add +45 % h_eff to a 0.30 mm-gap core. That makes possible a screen-free SKU that still beats CoolIT on every thermal metric.

**Headline at 15 kW / 18 LPM / 45 C (robust core JH-R, Tier-1 PCM pad, Monte-Carlo median and P90 in brackets):**
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
