rezgh92/CoolitBeat/cad/renders/section_header.png

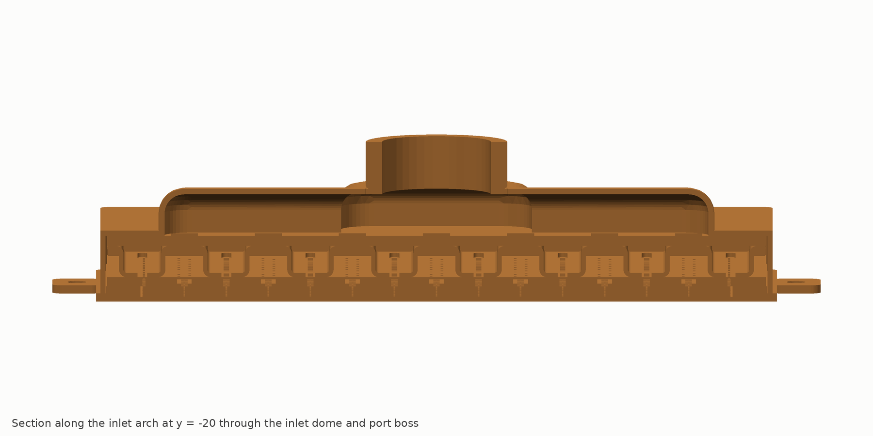
cad/renders/section_header.png
