rezgh92/CoolitBeat/cad/renders/section_inlet_closeup.png

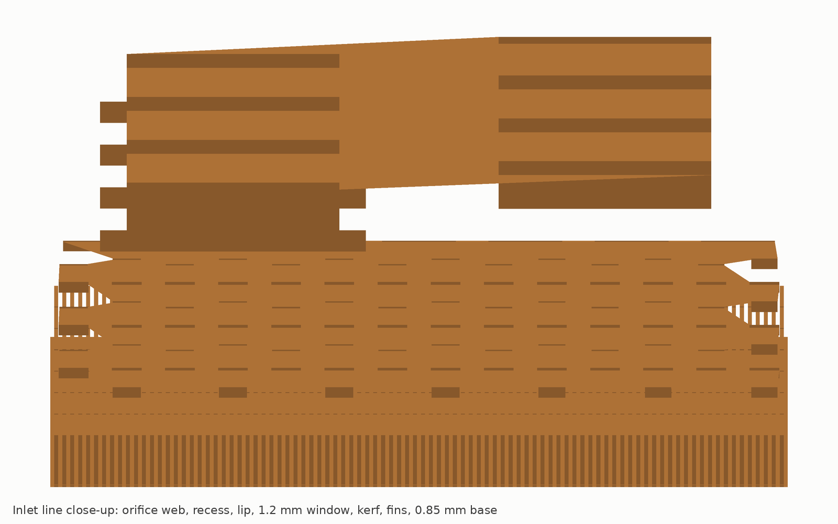
cad/renders/section_inlet_closeup.png
