rezgh92/CoolitBeat/cad/drawings/plenum_flat.dxf

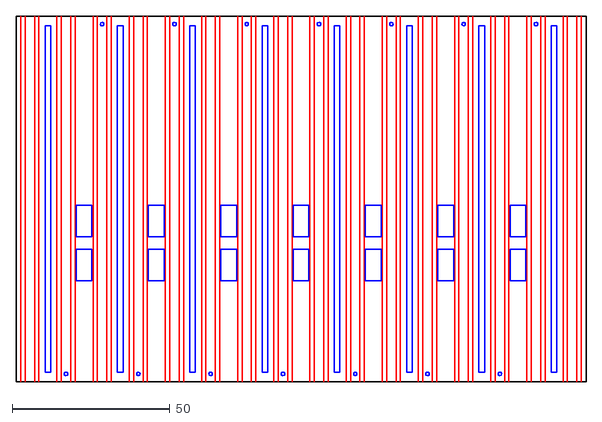
[picture p16: CAD file, 2026-10-16]
cad/drawings/plenum_flat.dxf
180.9 x 116.0
