rezgh92/CoolitBeat/cad/out/boss_out.stl

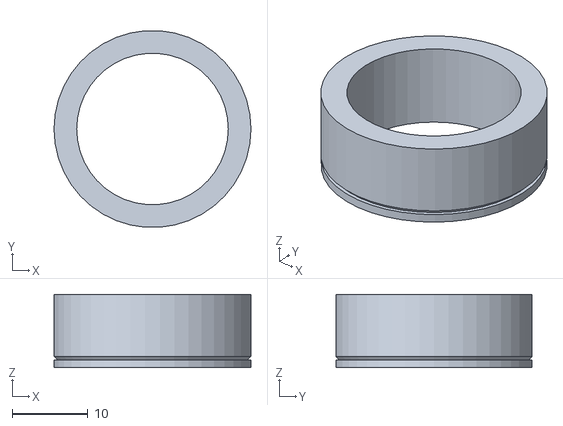
[picture p17: CAD file, 2026-10-16]
cad/out/boss_out.stl
26.0 x 25.9 x 9.70
