rezgh92/CoolitBeat/design/artwork_prism15_ttv.dxf

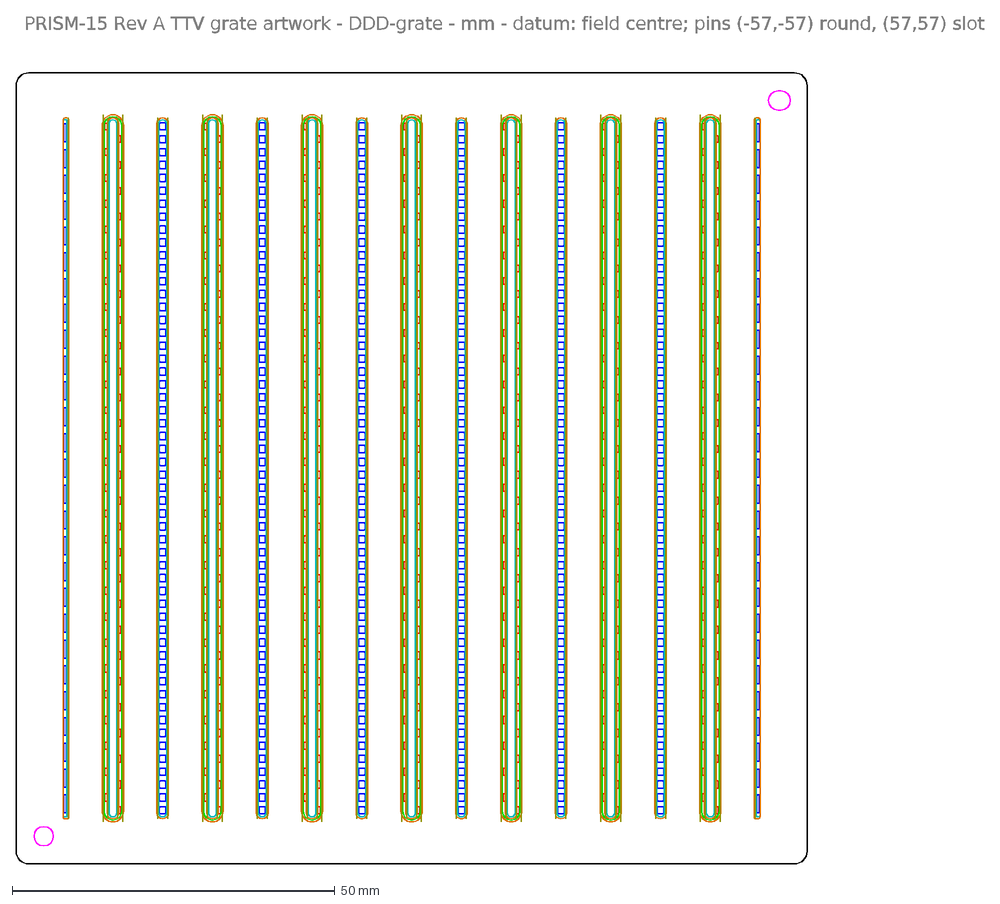
[picture p18: CAD file, 2026-10-16]
design/artwork_prism15_ttv.dxf
PRISM-15 Rev A TTV grate artwork - DDD-grate - mm - datum: field centre; pins (-57,-57) round, (57,57) slot
