rezgh92/CoolitBeat/cad/drawings/artwork_prism_g_example.dxf

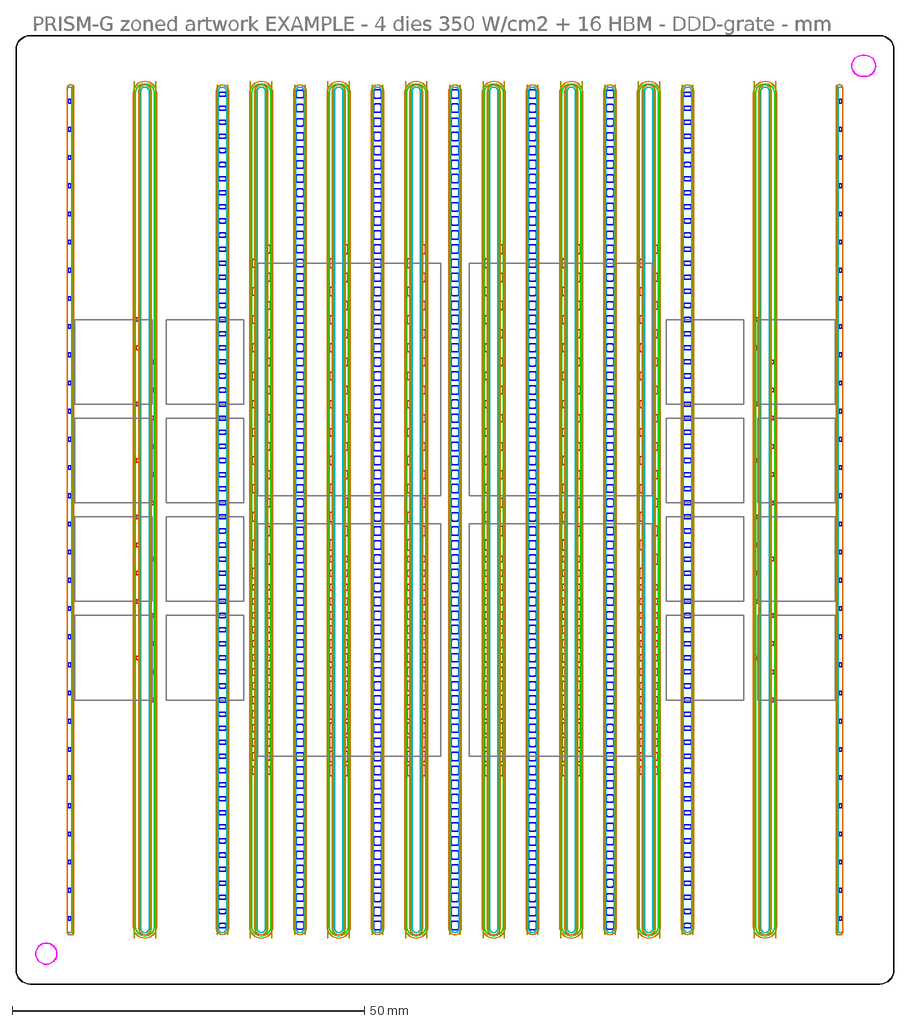
[picture p19: CAD file, 2026-10-16]
cad/drawings/artwork_prism_g_example.dxf
PRISM-G zoned artwork EXAMPLE - 4 dies 350 W/cm2 + 16 HBM - DDD-grate - mm
