rezgh92/CoolitBeat/cad/out/grate_web.stl

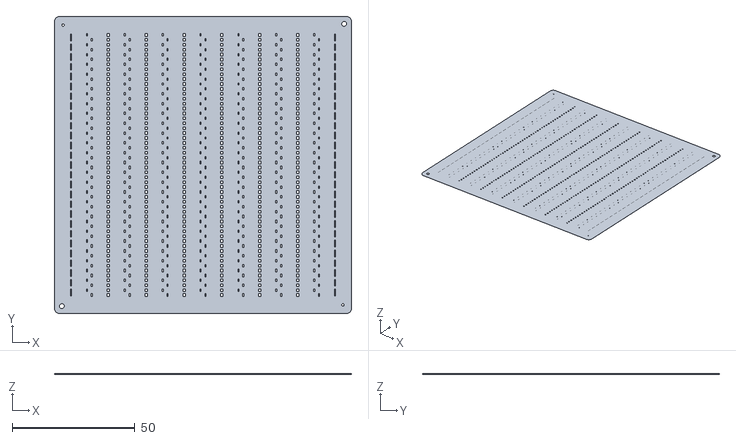
[picture p20: CAD file, 2026-10-16]
cad/out/grate_web.stl
121.0 x 121.0 x 0.4
