rezgh92/CoolitBeat/cad/out/ttv_block.stl

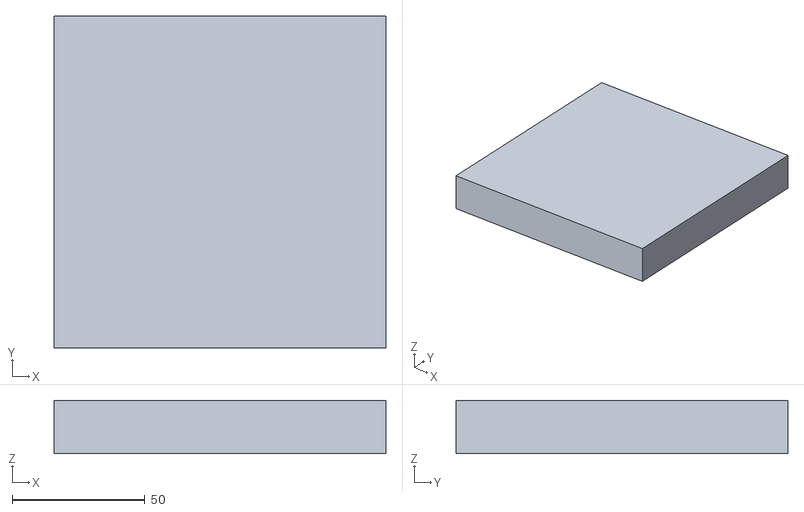
[picture p21: CAD file, 2026-10-16]
cad/out/ttv_block.stl
125.0 x 125.0 x 20.0
