rezgh92/CoolitBeat/cad/drawings/separator_windows.dxf

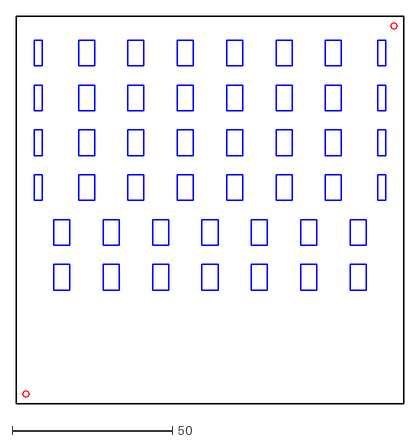
[picture p22: CAD file, 2026-10-16]
cad/drawings/separator_windows.dxf
121.0 x 121.0
