rezgh92/CoolitBeat/cad/out/plenum.stl

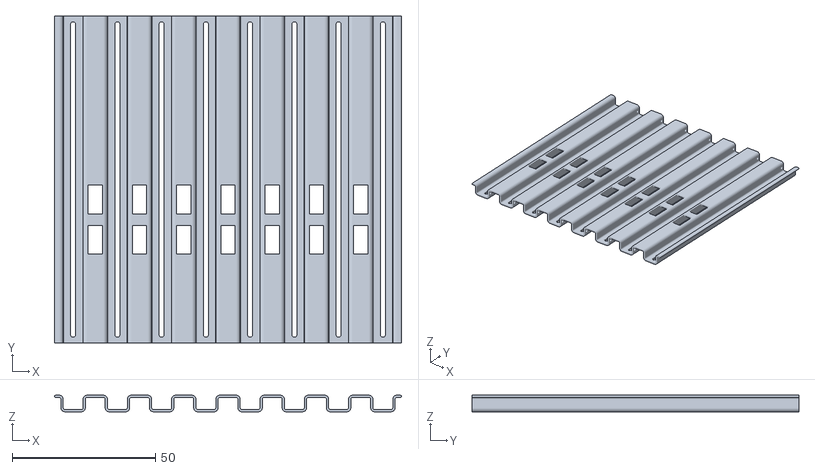
[picture p23: CAD file, 2026-10-16]
cad/out/plenum.stl
121.0 x 114.0 x 5.80
