rezgh92/CoolitBeat/cad/out/section_outlet.stl

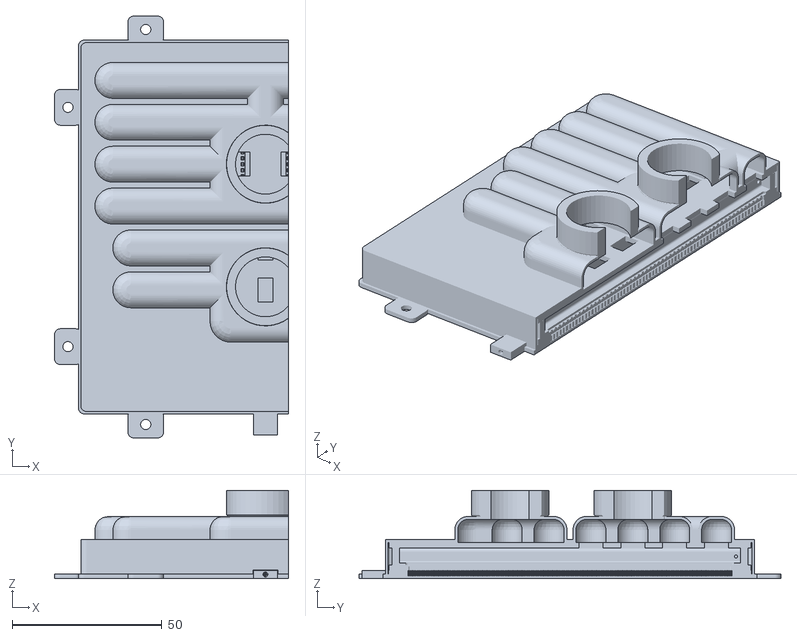
[picture p24: CAD file, 2026-10-16]
cad/out/section_outlet.stl
78.2 x 141.0 x 29.5
