rezgh92/CoolitBeat/cad/out/ttv_tiles.stl

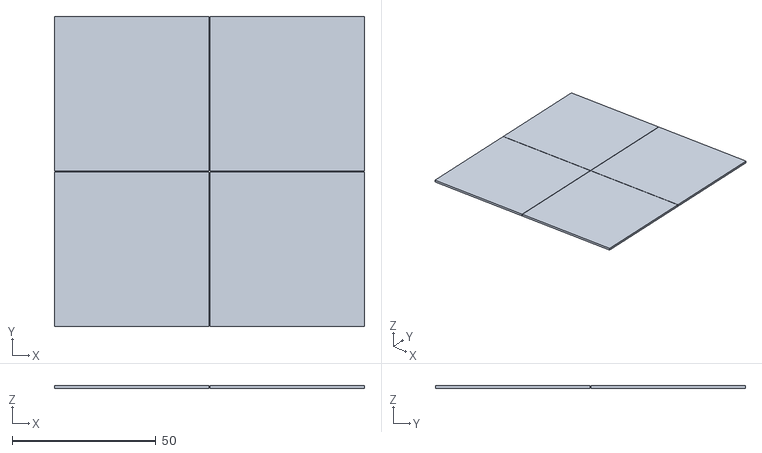
[picture p25: CAD file, 2026-10-16]
cad/out/ttv_tiles.stl
107.8 x 107.8 x 1.00
