rezgh92/CoolitBeat/cad/out/section_across.stl

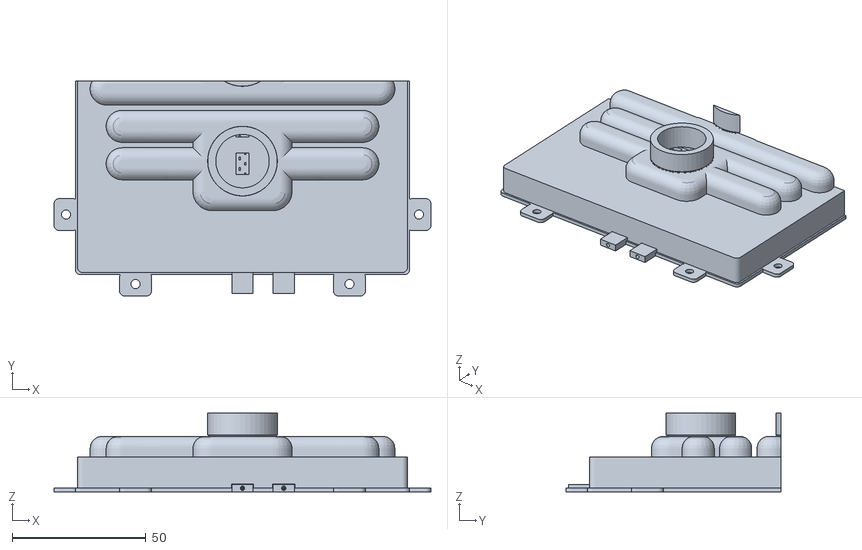
[picture p26: CAD file, 2026-10-16]
cad/out/section_across.stl
141.0 x 80.5 x 29.5
