rezgh92/CoolitBeat/cad/out/core.stl

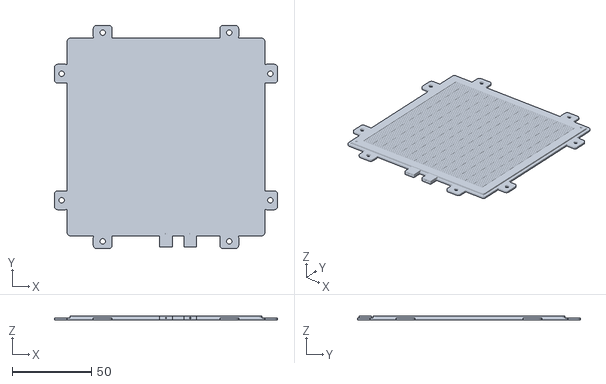
[picture p27: CAD file, 2026-10-16]
cad/out/core.stl
141.0 x 141.0 x 2.80
