rezgh92/CoolitBeat/cad/out/section_header.stl

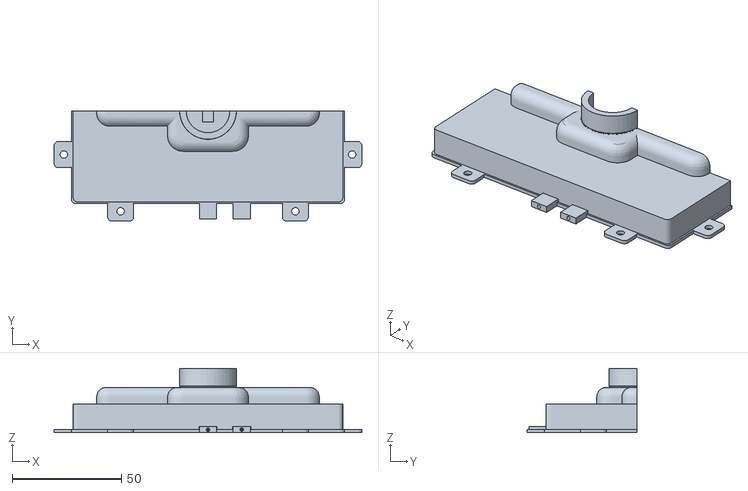
[picture p28: CAD file, 2026-10-16]
cad/out/section_header.stl
141.0 x 50.5 x 29.5
