rezgh92/CoolitBeat/cad/out/guard.stl

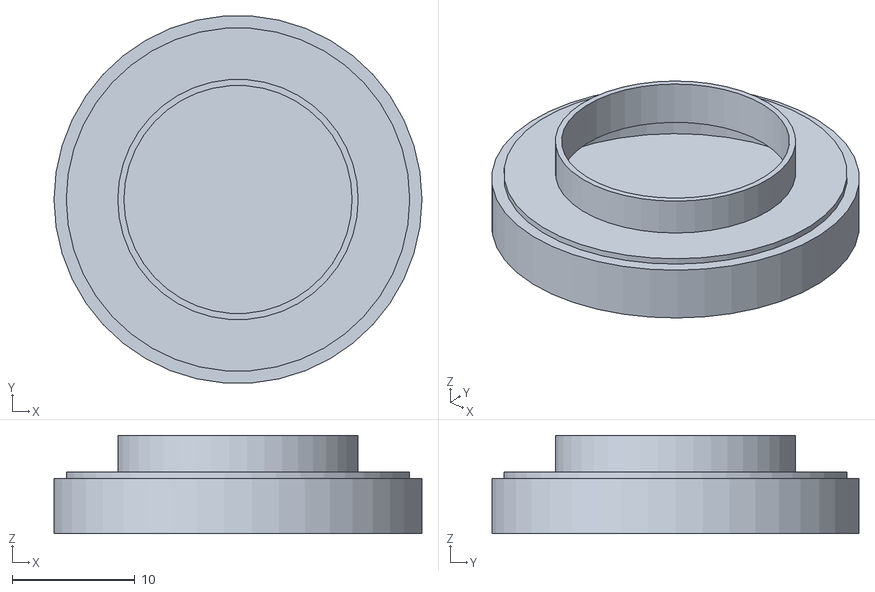
[picture p29: CAD file, 2026-10-16]
cad/out/guard.stl
30.0 x 29.9 x 8.00
