rezgh92/CoolitBeat/cad/out/cap.stl

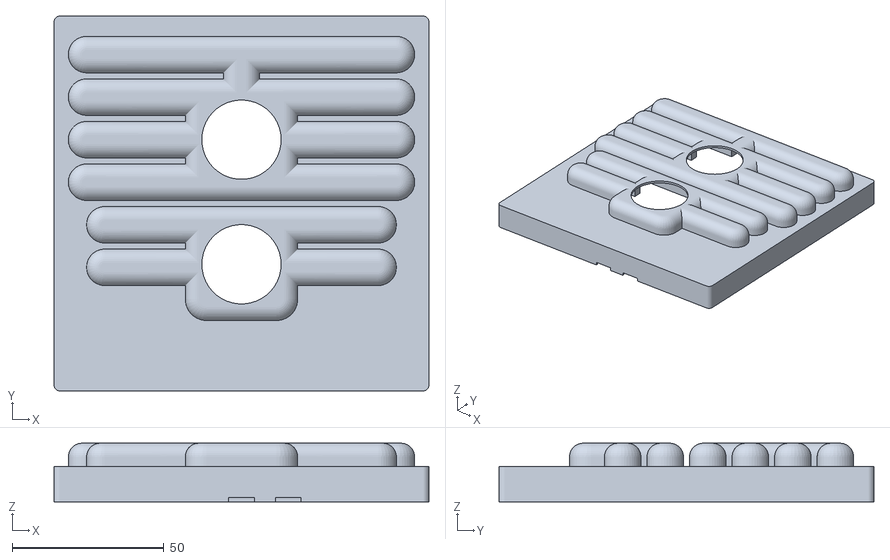
[picture p30: CAD file, 2026-10-16]
cad/out/cap.stl
123.4 x 123.4 x 19.3
