rezgh92/CoolitBeat/cad/out/separator.stl

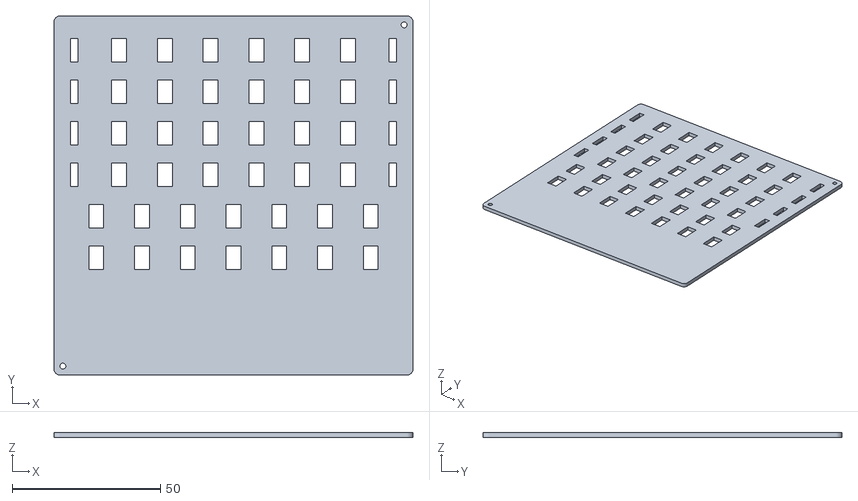
[picture p31: CAD file, 2026-10-16]
cad/out/separator.stl
121.0 x 121.0 x 1.80
