rezgh92/CoolitBeat/cad/out/section_inlet.stl

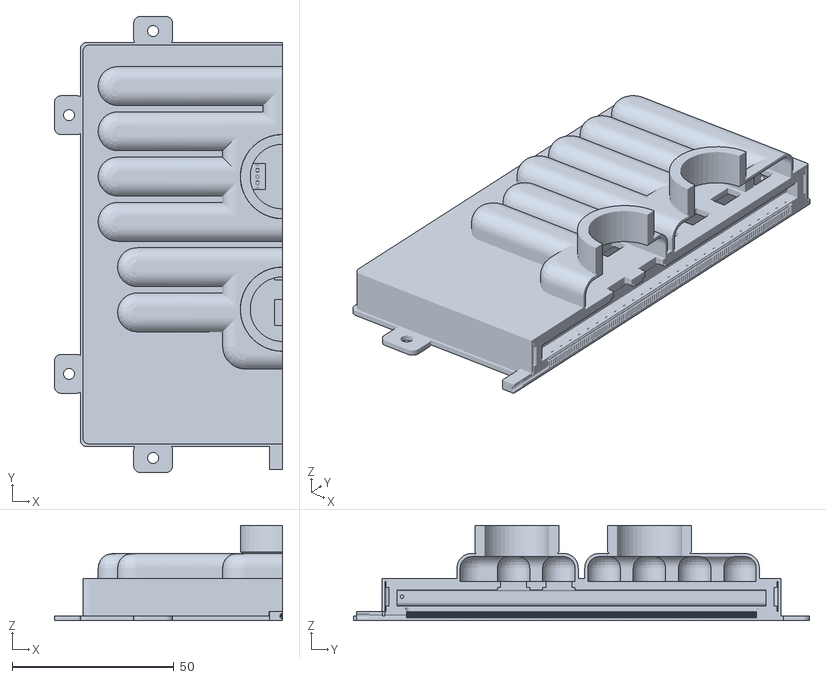
[picture p32: CAD file, 2026-10-16]
cad/out/section_inlet.stl
70.5 x 141.0 x 29.5
