rezgh92/CoolitBeat/cad/out/frame.stl

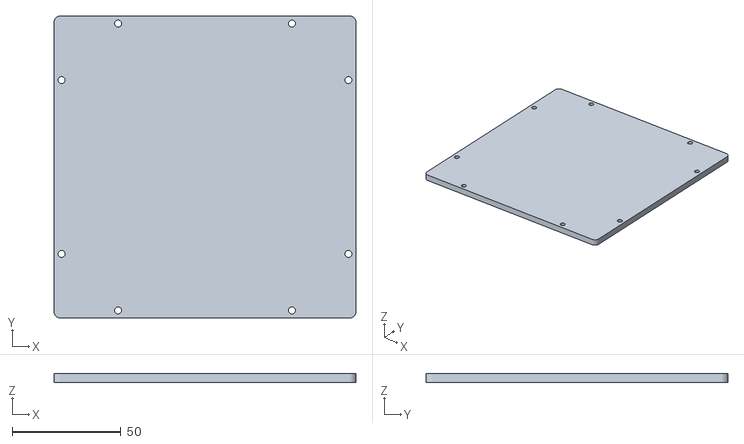
[picture p33: CAD file, 2026-10-16]
cad/out/frame.stl
139.0 x 139.0 x 4.00
