rezgh92/CoolitBeat/cad/out/plenum_frames.stl

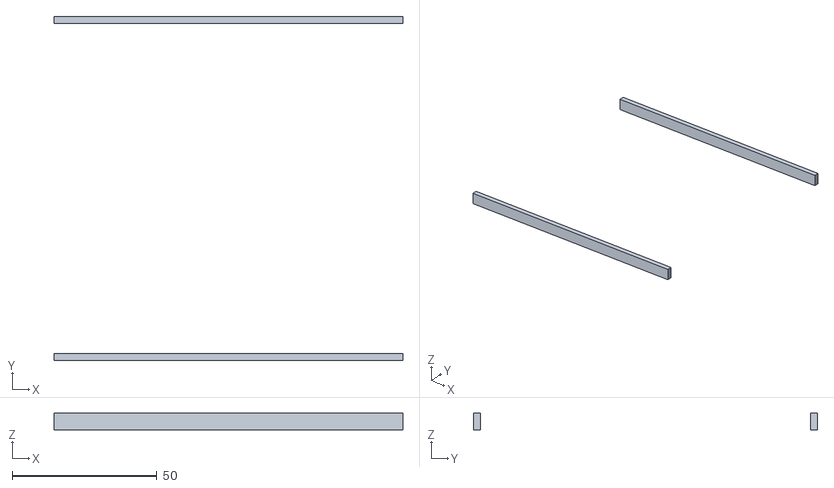
[picture p34: CAD file, 2026-10-16]
cad/out/plenum_frames.stl
120.7 x 119.0 x 5.78
