rezgh92/CoolitBeat/cad/out/grate_land.stl

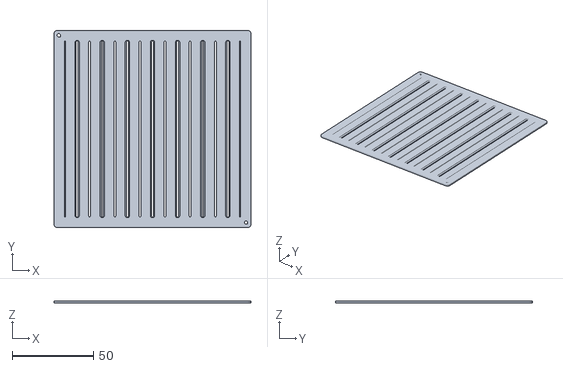
[picture p35: CAD file, 2026-10-16]
cad/out/grate_land.stl
121.0 x 121.0 x 1.30
