rezgh92/CoolitBeat/(list of files, cad)

Other CAD files:
cad/out/boss_in.stl
cad/out/screws.stl
