rezgh92/CoolitBeat/(commit log)

2026-10-16 PRISM-15 Rev A cold plate: design package
    Architecture of record and its verification, design-definition synthesis,
    eight design lanes with scripts and outputs, calibrated thermal-hydraulic
    model, parametric CAD (STEP, STL, DXF, drawings, renders), design report
    (PDF and source), review deck source, explainer-video pipeline, briefing,
    and the research and verification appendix.
    Claude-Session: https://claude.ai/code/session_01GhsZTCdbfjgacsM7LM7zog
    [artwork_prism15_ttv.csv, artwork_prism15_ttv.dxf, artwork_prism_g_example.csv, artwork_prism_g_example.dxf, bom.csv, boss_in.stl, boss_out.stl, cap.stl]
2026-10-16 Add the review deck as a structured PowerPoint file with its generator
    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
2026-10-16 Briefing: add how the plate is made and assembled
    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
